dzzie/humidor.net/hardware_picts/readme.md

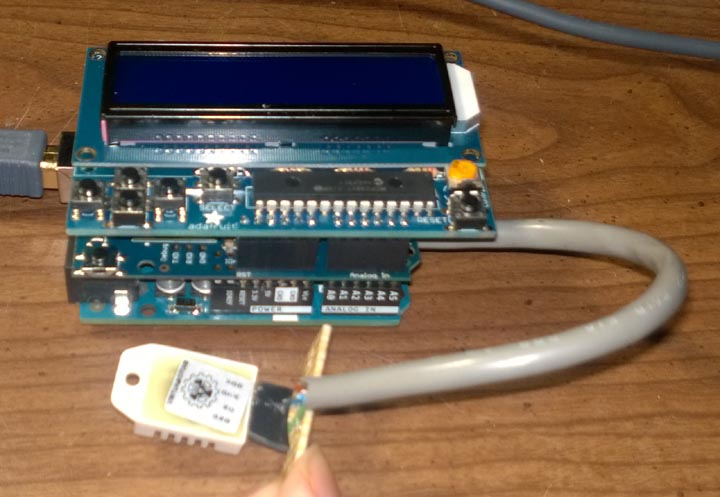
[picture p2: hardware_picts/assembled.jpg]

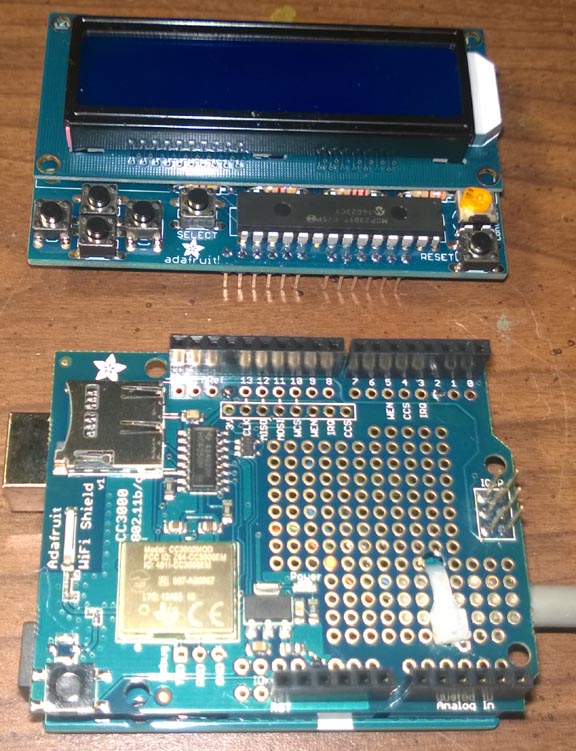
[picture p3: hardware_picts/wifi_shield.jpg]

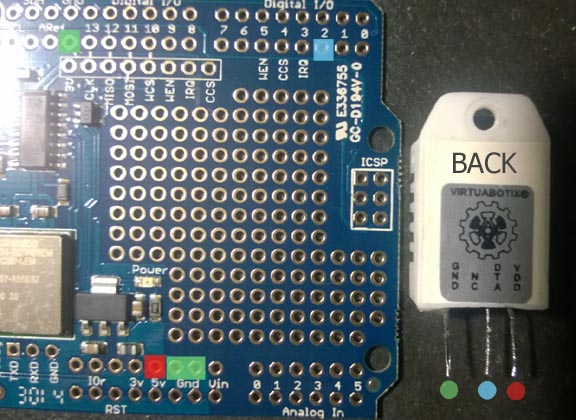
[picture p4: hardware_picts/wiring_points.jpg]

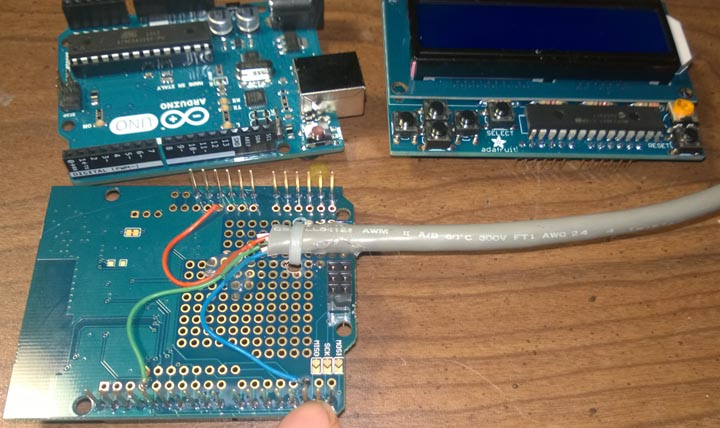
[picture p5: hardware_picts/sensor wiring.jpg]

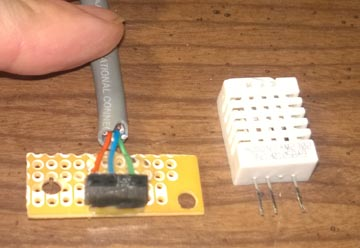
[picture p6: hardware_picts/sensor_connector.jpg]

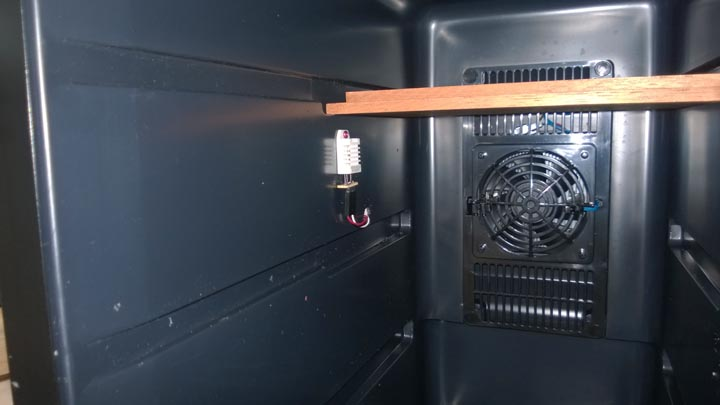
[picture p7: hardware_picts/sensor_installed.jpg]

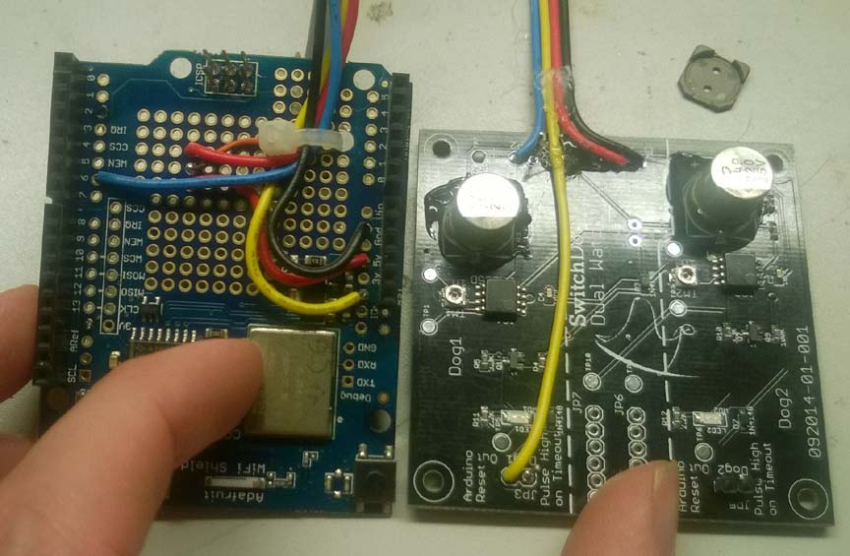
[picture p8: hardware_picts/external_watchdog.JPG]


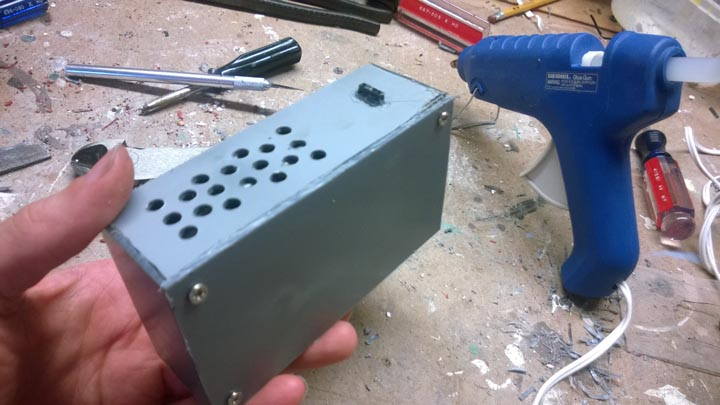
[picture p9: hardware_picts/enclosure_back.jpg]

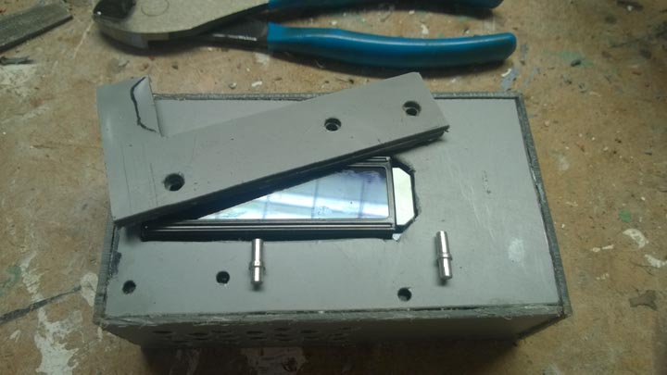
[picture p10: hardware_picts/enclosure_buttons.jpg]

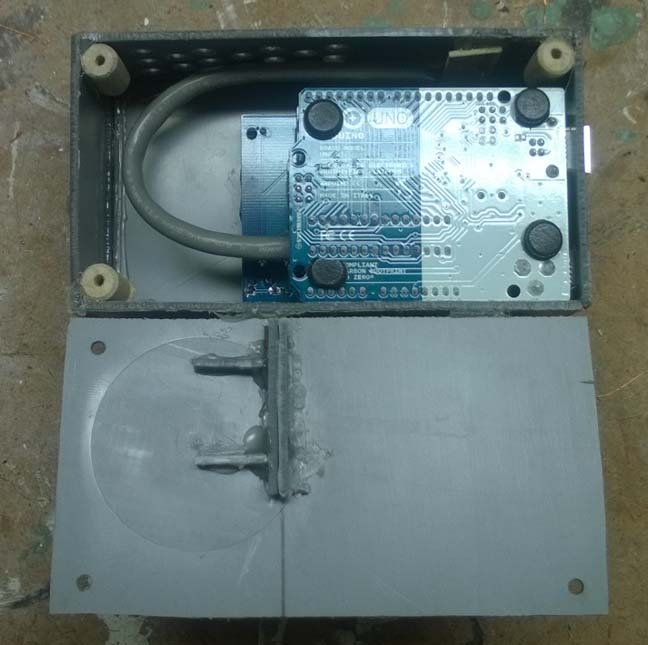
[picture p11: hardware_picts/inside_enclosure.jpg]

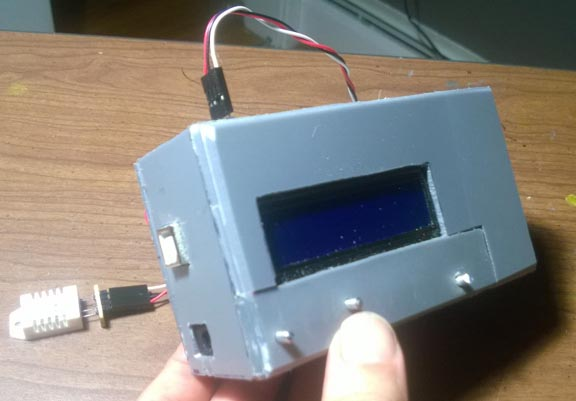
[picture p12: hardware_picts/enclosure_complete.jpg]


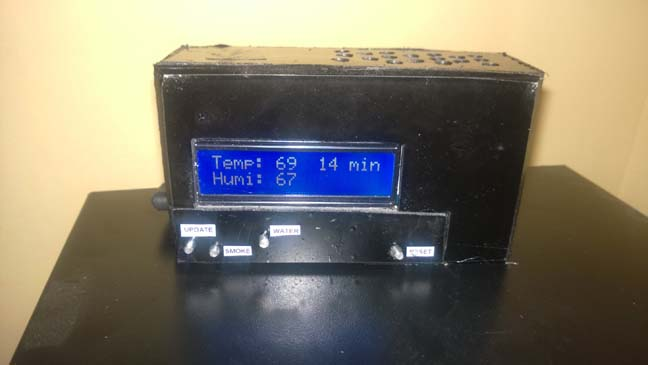
[picture p13: hardware_picts/running.jpg]
