dzzie/humidor.net/PhoneApp/readme.txt

this is essentially a wrapper around the mobile.php
web page in a webview control with some other options.

if you can pin a web url to your home screen you dont 
really a dedicated app but i wanted to play with 
windows phone dev a bit so..
