dzzie/humidor.net/hardware_picts/tft_picts/readme.md

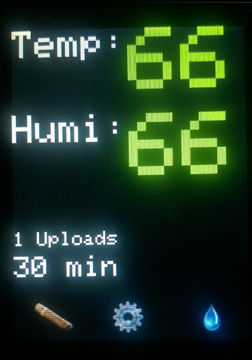
[picture p14: hardware_picts/tft_picts/main_screen.png]

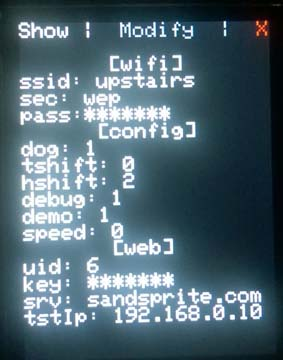
[picture p15: hardware_picts/tft_picts/config_show.jpg]

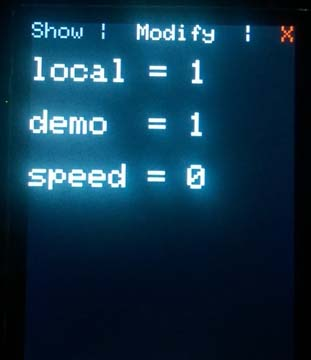
[picture p16: hardware_picts/tft_picts/config_modify.jpg]

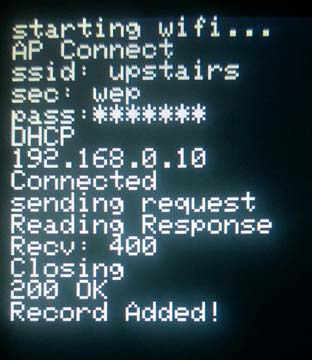
[picture p17: hardware_picts/tft_picts/uploading.jpg]

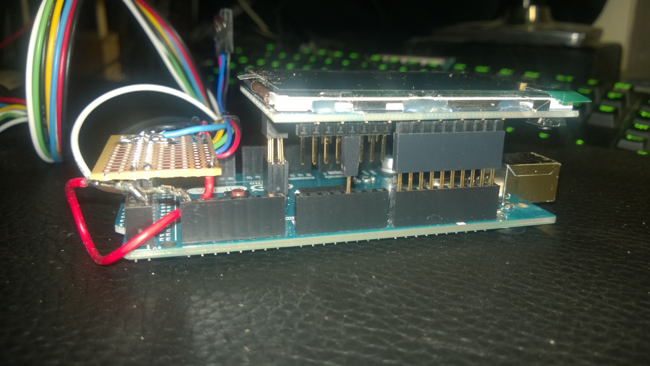
[picture p18: hardware_picts/tft_picts/WP_20151220_001.jpg]

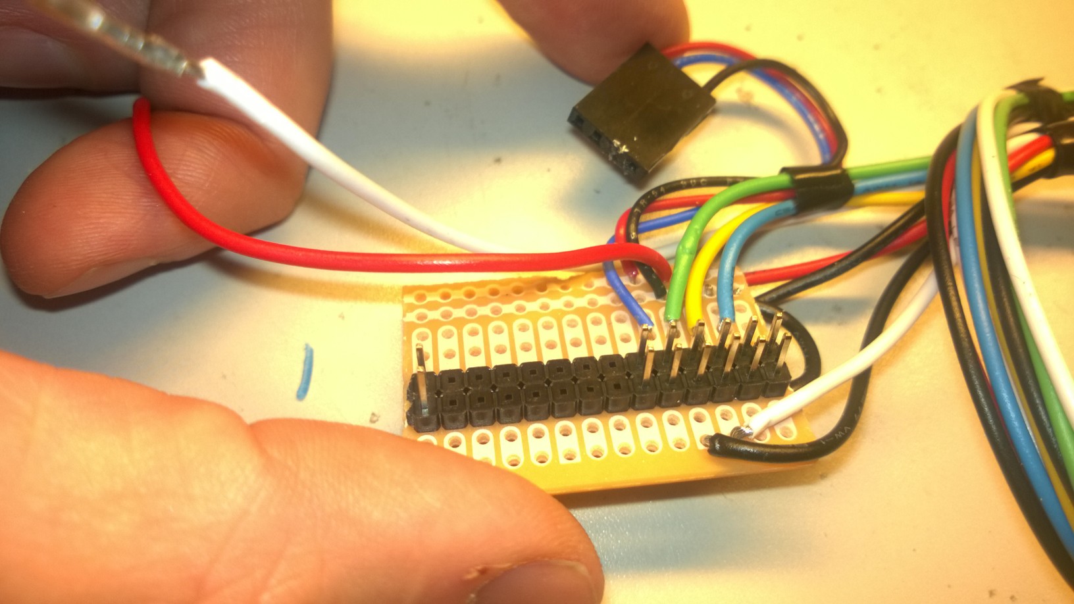
[picture p19: hardware_picts/tft_picts/WP_20151220_009.jpg]

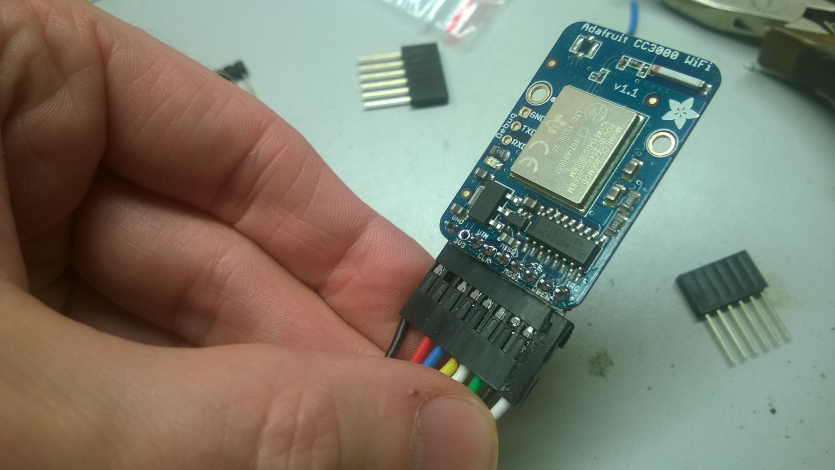
[picture p20: hardware_picts/tft_picts/WP_20151220_010.jpg]

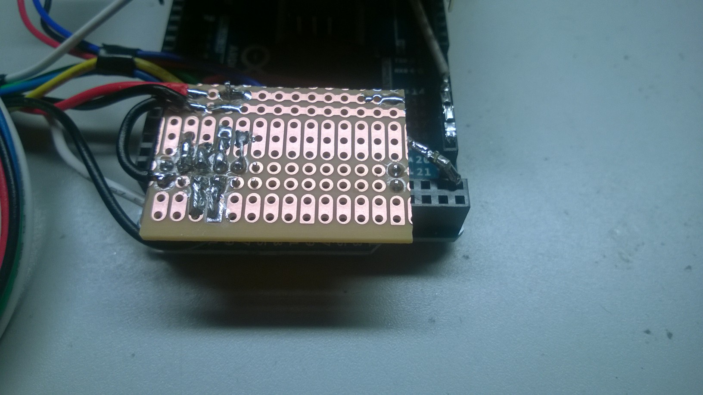
[picture p21: hardware_picts/tft_picts/WP_20151220_017.jpg]


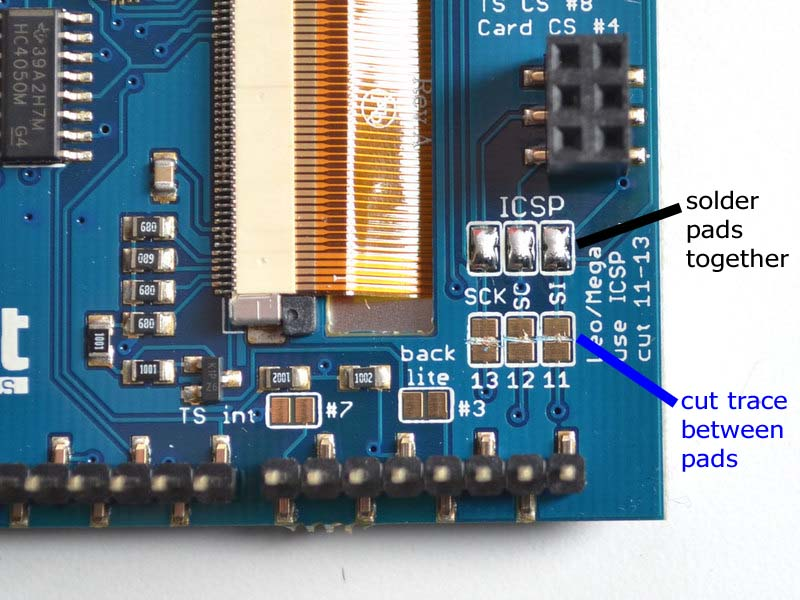
[picture p22: hardware_picts/tft_picts/tft_solder.jpg]

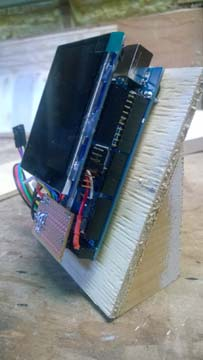
[picture p23: hardware_picts/tft_picts/WP_20151221_001.jpg]

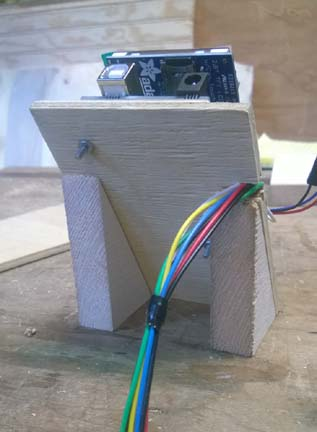
[picture p24: hardware_picts/tft_picts/WP_20151221_002.jpg]

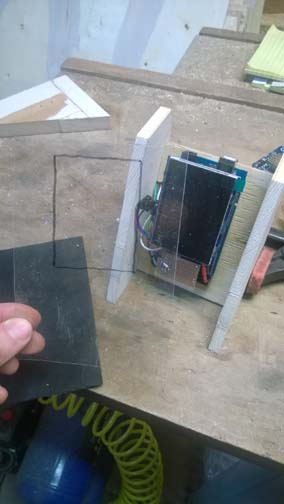
[picture p25: hardware_picts/tft_picts/WP_20151221_003.jpg]

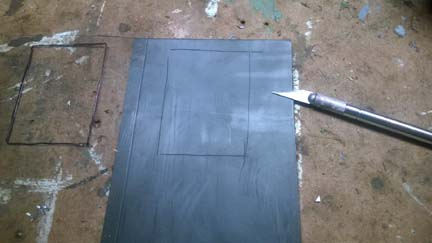
[picture p26: hardware_picts/tft_picts/WP_20151221_004.jpg]

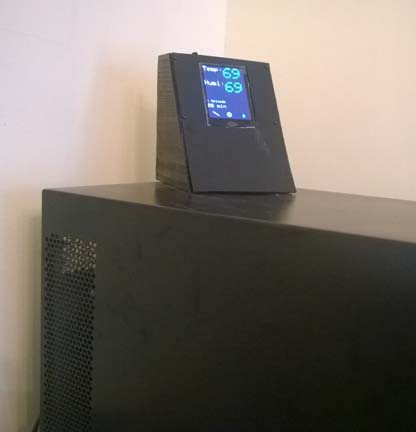
[picture p27: hardware_picts/tft_picts/WP_20151221_009.jpg]


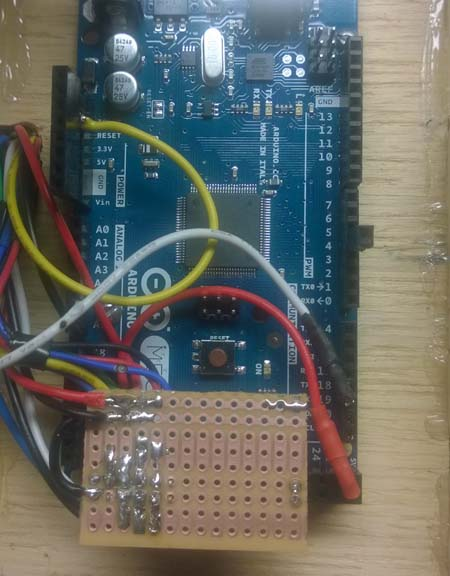
[picture p28: hardware_picts/tft_picts/WP_20151228_002.jpg]

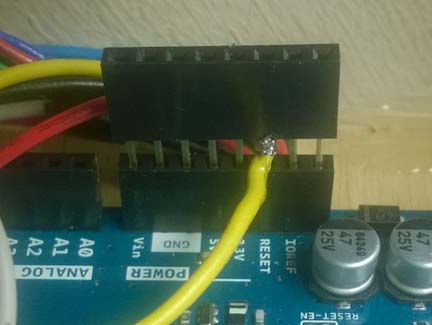
[picture p29: hardware_picts/tft_picts/WP_20151228_003.jpg]

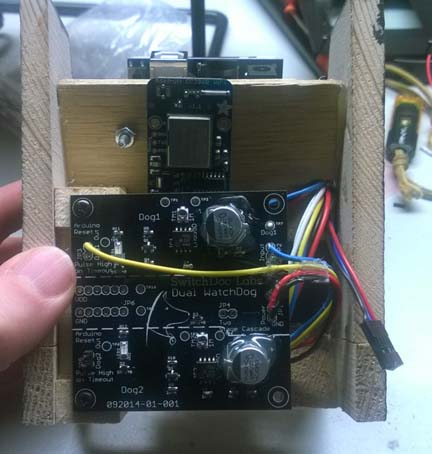
[picture p30: hardware_picts/tft_picts/WP_20151228_004.jpg]

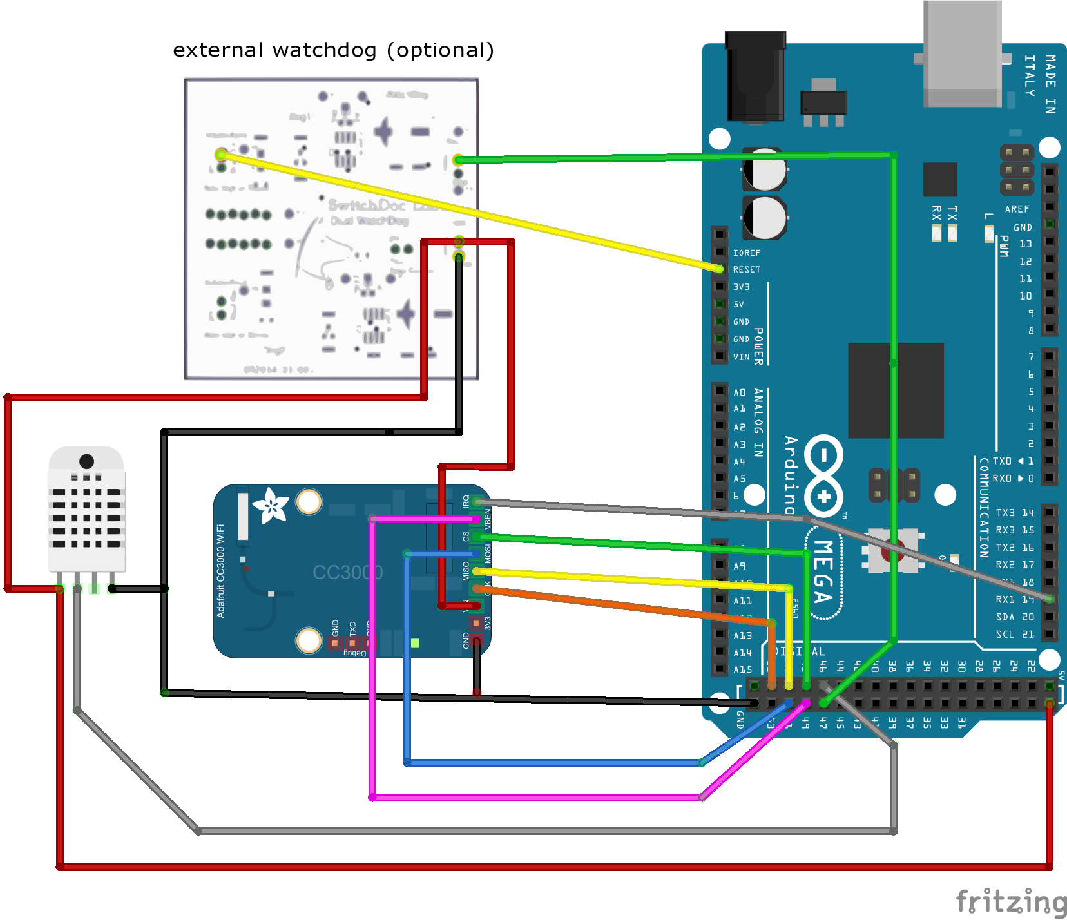
[picture p31: hardware_picts/tft_picts/v2_fritzing.png]

<br><br>
New case see readme:<br>
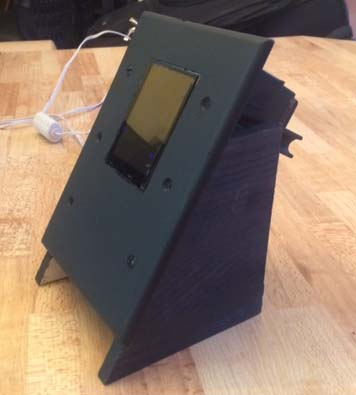
[picture p32: hardware_picts/tft_picts/v2_new_case.jpg]
