dzzie/humidor.net/Arduino/multi_sensor_version/screenshot.png

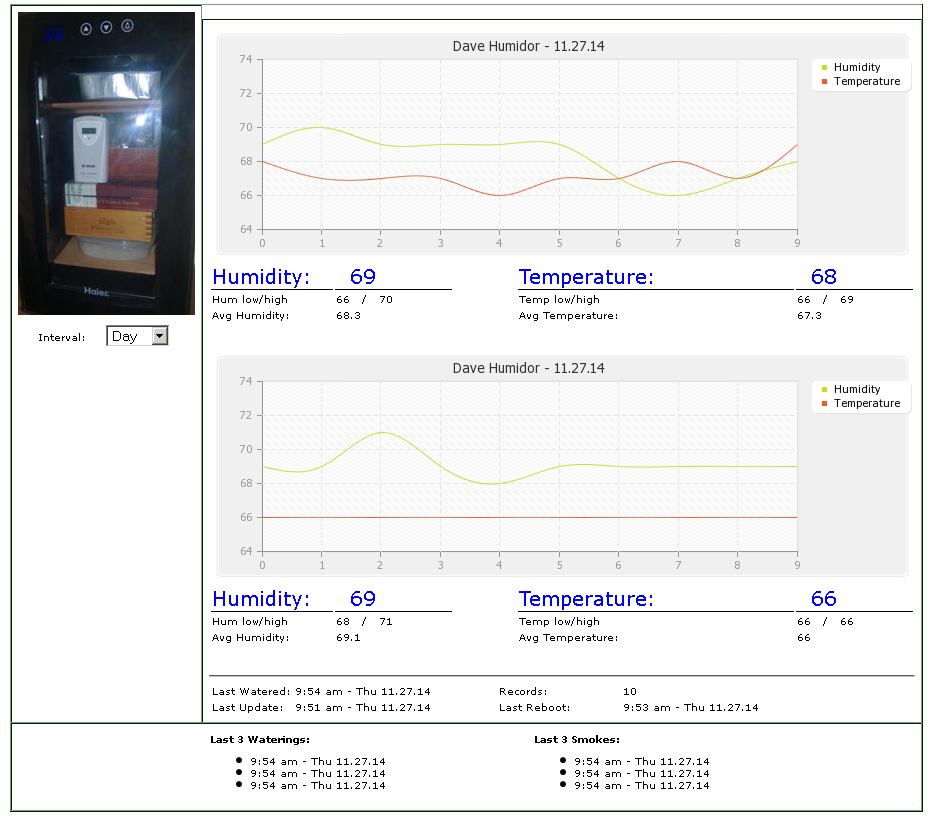
Arduino/multi_sensor_version/screenshot.png
