dzzie/humidor.net/Arduino/multi_sensor_version/web_root/example2.png

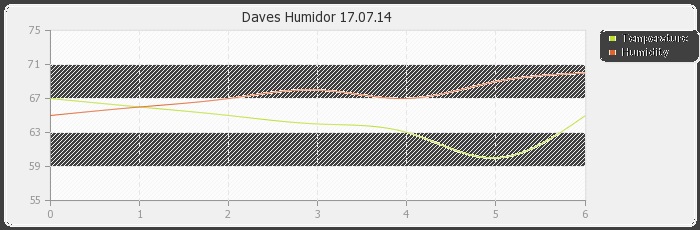
Arduino/multi_sensor_version/web_root/example2.png
