dzzie/humidor.net/Arduino/tft/SDCard_Files/sir.bmp

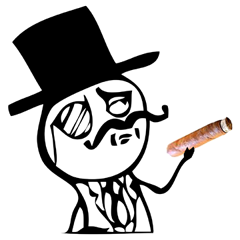
Arduino/tft/SDCard_Files/sir.bmp
