dzzie/humidor.net/hardware_picts/dht22_pinout.jpg

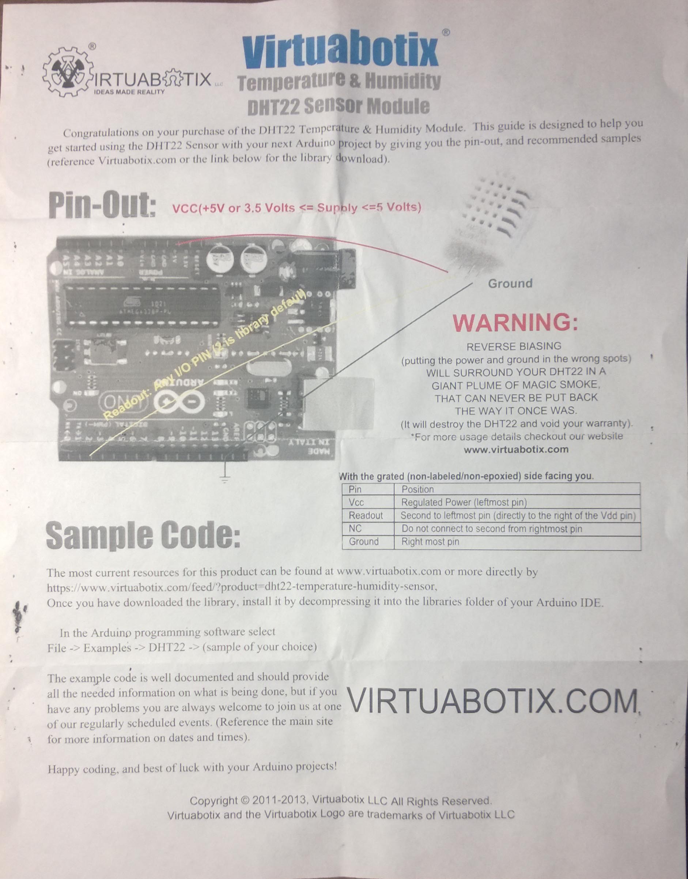
hardware_picts/dht22_pinout.jpg
