dzzie/humidor.net/help_file/img/dupont.jpg

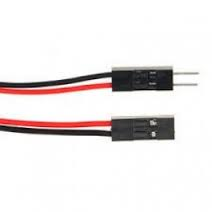
help_file/img/dupont.jpg
