dzzie/humidor.net/help_file/img/haier_temp_mod2.jpg

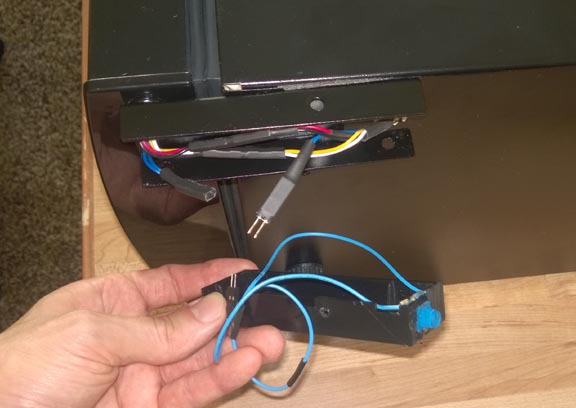
help_file/img/haier_temp_mod2.jpg
