dzzie/humidor.net/help_file/img/humidor.jpg

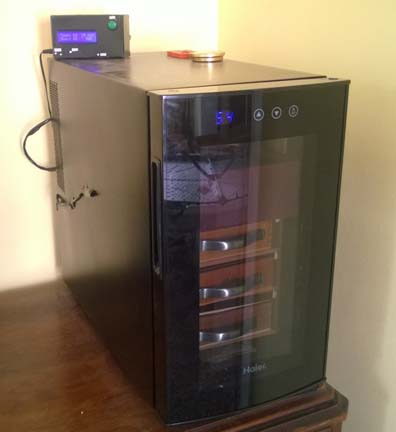
help_file/img/humidor.jpg
