dzzie/humidor.net/help_file/img/pins_used.png

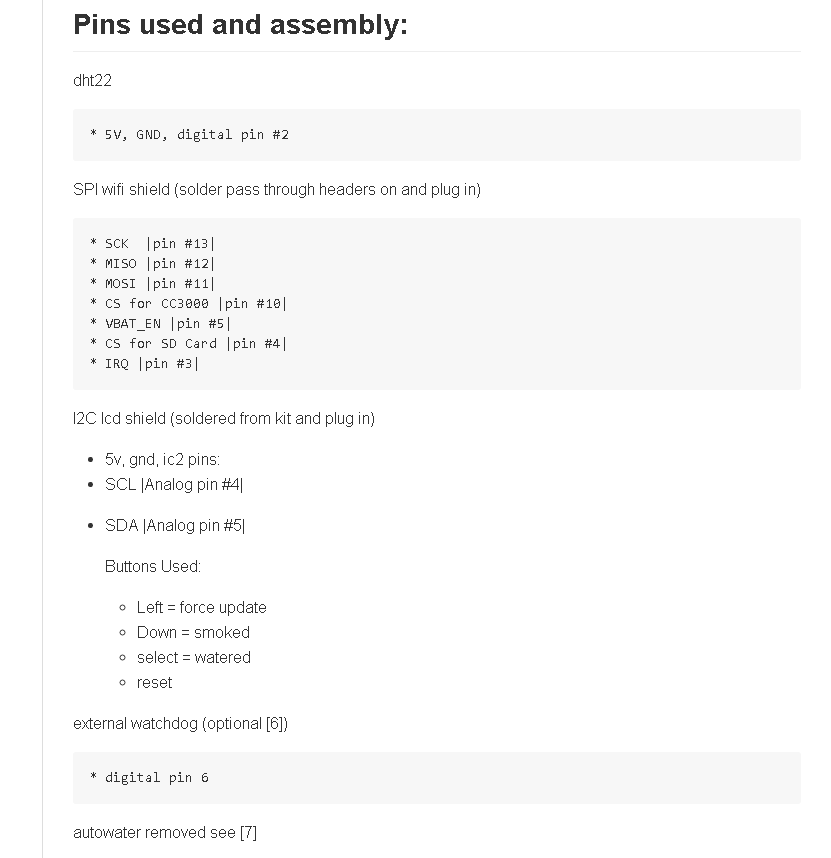
help_file/img/pins_used.png
