dzzie/humidor.net/help_file/img/set_timeout.png

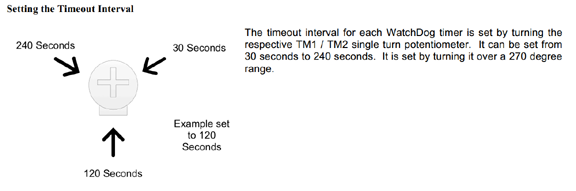
help_file/img/set_timeout.png
