dzzie/humidor.net/help_file/img/v1_running.jpg

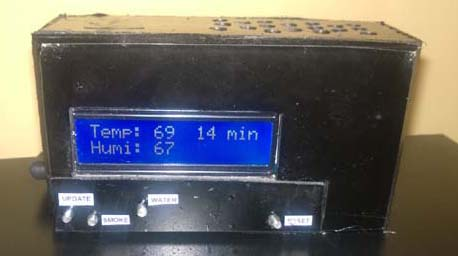
help_file/img/v1_running.jpg
