dzzie/humidor.net/help_file/img/v2/WP_20151220_009.jpg

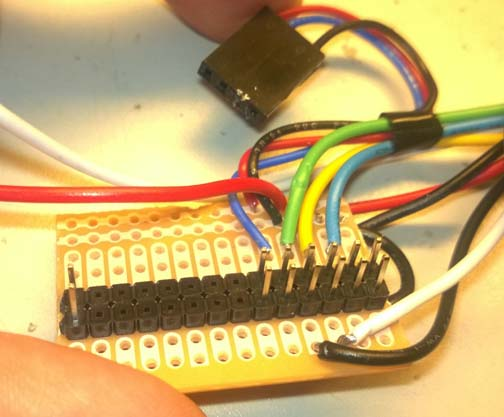
help_file/img/v2/WP_20151220_009.jpg
