dzzie/humidor.net/help_file/img/v2/WP_20151220_017.jpg

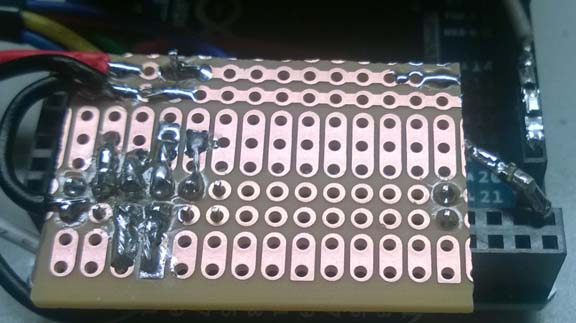
help_file/img/v2/WP_20151220_017.jpg
