dzzie/humidor.net/help_file/img/v2_running.jpg

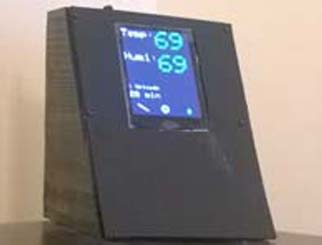
help_file/img/v2_running.jpg
