dzzie/humidor.net/help_file/img/wp_actions.png

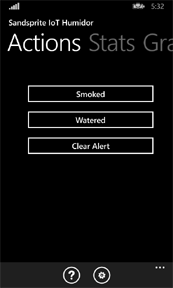
help_file/img/wp_actions.png
