dzzie/humidor.net/help_file/img/wp_graph.png

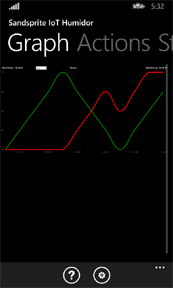
help_file/img/wp_graph.png
