dzzie/humidor.net/help_file/img/wp_live_tile.png

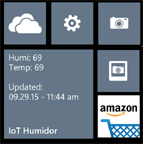
help_file/img/wp_live_tile.png
