dzzie/humidor.net/help_file/img/wp_settings.png

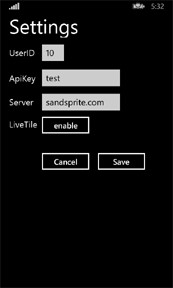
help_file/img/wp_settings.png
