dzzie/humidor.net/help_file/img/wp_stats.png

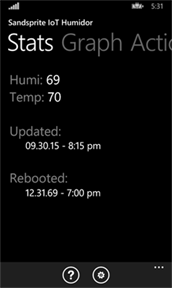
help_file/img/wp_stats.png
