dzzie/humidor.net/PhoneApp/wp8.1/Screenshots/about.png

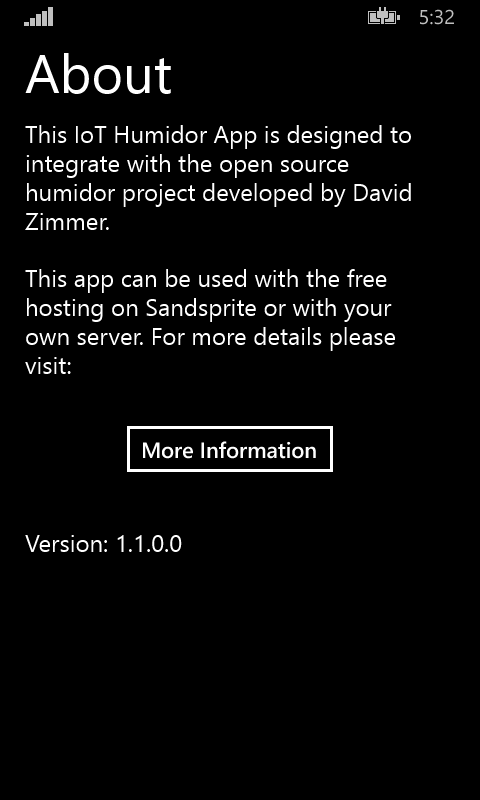
PhoneApp/wp8.1/Screenshots/about.png
