dzzie/humidor.net/PhoneApp/wp8.1/Screenshots/settings.png

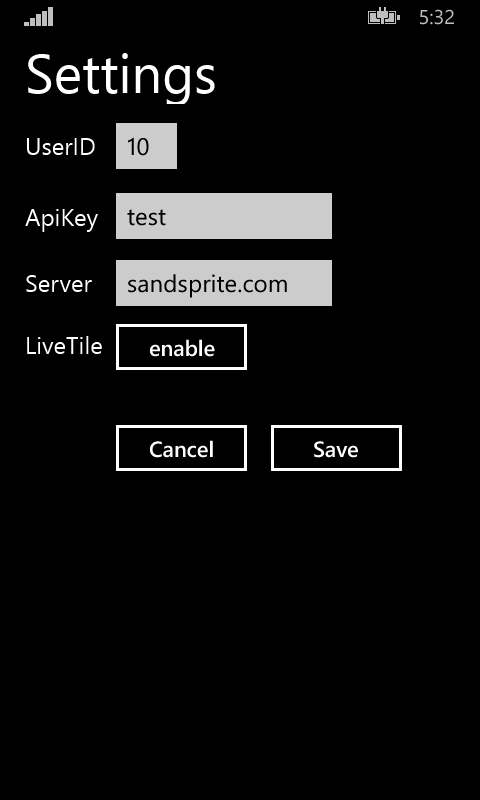
PhoneApp/wp8.1/Screenshots/settings.png
