dzzie/humidor.net/PhoneApp/wp8.1/Screenshots/stats.png

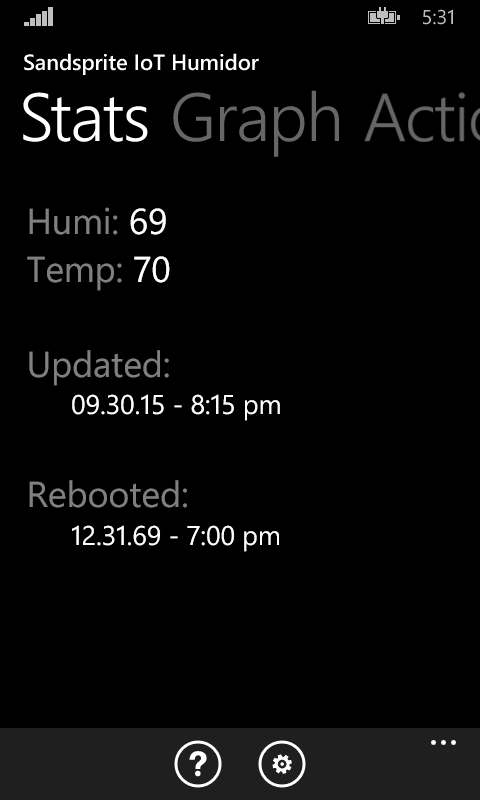
PhoneApp/wp8.1/Screenshots/stats.png
