dzzie/humidor.net/hardware_picts/low_cost/readme.md

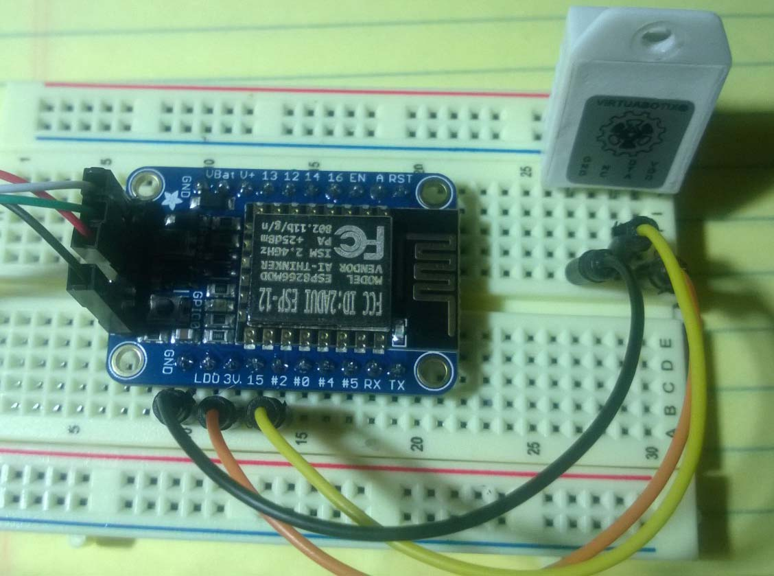
[picture p55: hardware_picts/low_cost/low_cost.jpg]
