dzzie/humidor.net/help_file/img/low_cost_sm.jpg

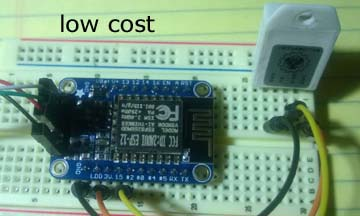
help_file/img/low_cost_sm.jpg
