dzzie/humidor.net/help_file/img/assembled.jpg

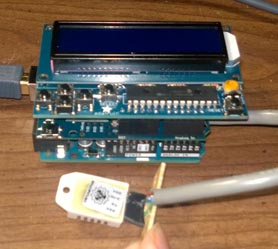
help_file/img/assembled.jpg
