dzzie/humidor.net/help_file/img/builds.jpg

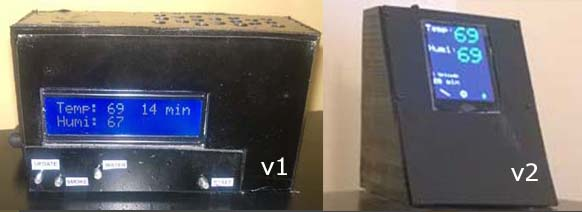
help_file/img/builds.jpg
