dzzie/humidor.net/help_file/img/sensor_installed.jpg

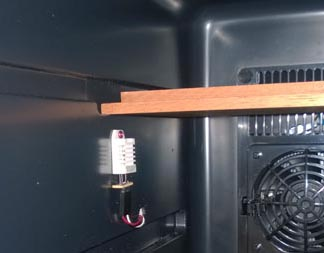
help_file/img/sensor_installed.jpg
