dzzie/humidor.net/.todo.txt

android & iOS phone apps?

able to switch between dht22 and sht31
https://learn.adafruit.com/adafruit-sht31-d-temperature-and-humidity-sensor-breakout
