dzzie/humidor.net/(list of files, drawings)

Other design files:
fritzing/v2.fzz
