dzzie/humidor.net/Arduino/low_cost/public.h

//edit this and save it as private.h

const char* ssid     = "my_wifiname";
const char* password = "my_password";
const char* host     = "sandsprite.com";

char* APIKEY = "123456";
int   client_id = 0 ;
