dzzie/humidor.net/Arduino/multi_sensor_version/humidor/settings.h

#ifndef SETTINGS_H
#define SETTINGS_H

//------------------ wifi sheild --------------------

// These are the interrupt and control pins
#define ADAFRUIT_CC3000_IRQ   3  // MUST be an interrupt pin!
// These can be any two pins
#define ADAFRUIT_CC3000_VBAT  5
#define ADAFRUIT_CC3000_CS    10
// Use hardware SPI for the remaining pins
// On an UNO, SCK = 13, MISO = 12, and MOSI = 11
Adafruit_CC3000 cc3000 = Adafruit_CC3000(ADAFRUIT_CC3000_CS, ADAFRUIT_CC3000_IRQ, ADAFRUIT_CC3000_VBAT, SPI_CLOCK_DIVIDER); 
// you can change this clock speed

#define IDLE_TIMEOUT_MS  3000      // Amount of time to wait (in milliseconds) with no data 
                                   // received before closing the connection.  If you know the server
                                   // you're accessing is quick to respond, you can reduce this value.

//------------------ END wifi sheild --------------------                                   
                                   
#define WHITE 0x7 //for lcd backlight                                   
                                   
                                   
#endif // SETTINGS_H
