dzzie/humidor.net/Arduino/tests/yun_config/config.txt

6,0,2,test,sandsprite.com

# sample config file first line must be the config settings
# the format is userid, deltaT, deltaH, apikey, server  
# no spaces, this data after doent matter.
