dzzie/humidor.net/(commit log)

2014-07-19 added initial arduino sketch
2014-07-20 arduino code complete
2014-07-21 left button immediate update, show countdown on lcd
2014-07-26 arduino: shows http response, removed serial, better error displays, possible revert if not stable..(size getting to big?)
    [humidor.ino]
2014-07-29 added .htaccess to disable chunked and gzip transfers, switched from test server to public website, support for php4 added (file_get/put_contents added on demand if missing)
    [humidor.ino]
2014-07-29 web: timezone fix, no cache alerts; arduino: lcd out domain
    [humidor.ino]
2014-10-10 dns caching, firmware/rev/date on startup, logic to detect/reject bad sensor reads
2014-10-27 failcnt after postdata, sensor readings shifts, better postdata cleanup
    [humidor.ino, public.h]
2014-11-02 added button for logging smoke times
2014-11-04 rework to stay under 28k code size
    [humidor.ino]
2014-11-29 switched to chartjs (client side), added next/prev links
2014-12-04 switch multisensor version to chartjs
2014-12-22 autowater tweak and speedMode, web stats fix, port changes to multisensor version.
    [humidor.ino]
2014-12-25 changed pump switch to software read so wont show as watered in web if it didnt really run
2015-04-10 fixed occasional hang in ReadResponse(?) added progress bar to read loop
    [humidor.ino]
2015-04-10 disabled autowater, switched progress bar to time delay countdown
2015-05-10 revert to old pb bar code
    [humidor.ino]
2015-05-12 testing watchdog timer to prevent lockups from lasting to long..
    [humidor.ino]
2015-05-21 switched to long watchdog code, thanks to Dave Evans and Philip Allagas !
2015-06-13 display bug: WS flags now overwrite upload count completely
    [humidor.ino]
2015-09-11 -autowater (boveda), simplified fail_cnt, changed progress bar to count
    [humidor.ino]
2015-09-29 wp bugfix: unregister task name, calling tightened, screen shots
2015-10-10 serial config code complete (vb6 ui and arduino test project)
2015-11-09 added actions.webui button
2015-11-30 added tft build, moved multisensor and serial config
    [config.txt]
2015-12-15 tft: demo mode (no leak config in video demos)
    [tft.ino]
2015-12-16 preparing for switch to Ben Hoyt's lite weight inih library (BSD license)
2015-12-17 tft switched out ini library
2015-12-20 tft: fastrprint bug work around.. (gets buggy with length apparently)
    [ini.h, tft.ino]
2015-12-21 tft enclosure picts, 5 min delay if failed upload (v1 & 2)
    [humidor.ino, tft.ino]
2015-12-22 changed cc3000 irq to pin 18 (stability reasons), activeIP cache bug when switching to local mode in debug screen
    [tft.ino]
2015-12-26 switched back to getHostByName(DOMAIN) lookup (cached at startup)
2015-12-27 if fail_cnt > 2 do fresh lookup on hostname in case stale..
    [humidor.ino, tft.ino]
2015-12-27 tft: added reload cfg button on modify pane (take out sdcard, update, refresh while running)
2016-01-01 tft: support sht31 sensor if present, dht22 fall back, optimized sht31 library
2016-01-01 tft: added read sensor to modify screen
2016-01-13 tft: added fritzing images and files for v2, added v3 low cost to help file
    [v2.fzz]
2016-12-19 V2 case upgraded to actual electrical enclosure box
